abhaycashikar/tada68_custom_pcb/README.md

# tada68_custom_pcb
See details and pictures on [my website](https://abhaycashikar.github.io/keyboard_pcb.html)!
