abhaycashikar/tada68_custom_pcb/FA-238/FA-238.step

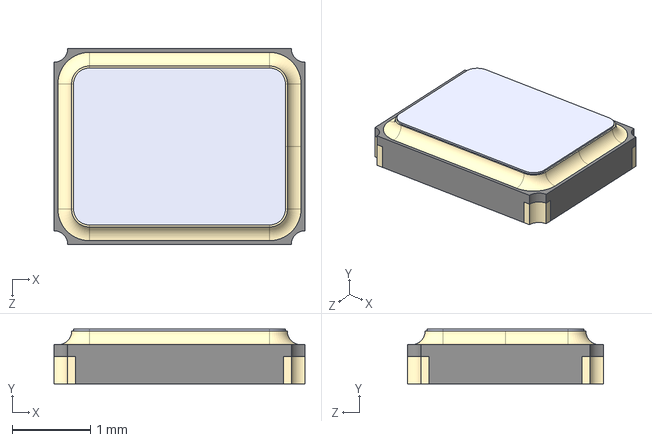
[picture p3: CAD file, 2021-10-26]
FA-238/FA-238.step
3.20 x 0.7 x 2.50 mm
